G-Levine/OpenTorque-Actuator/README.md

# OpenTorque Actuator
### A powerful, compliant actuator for legged robotics.

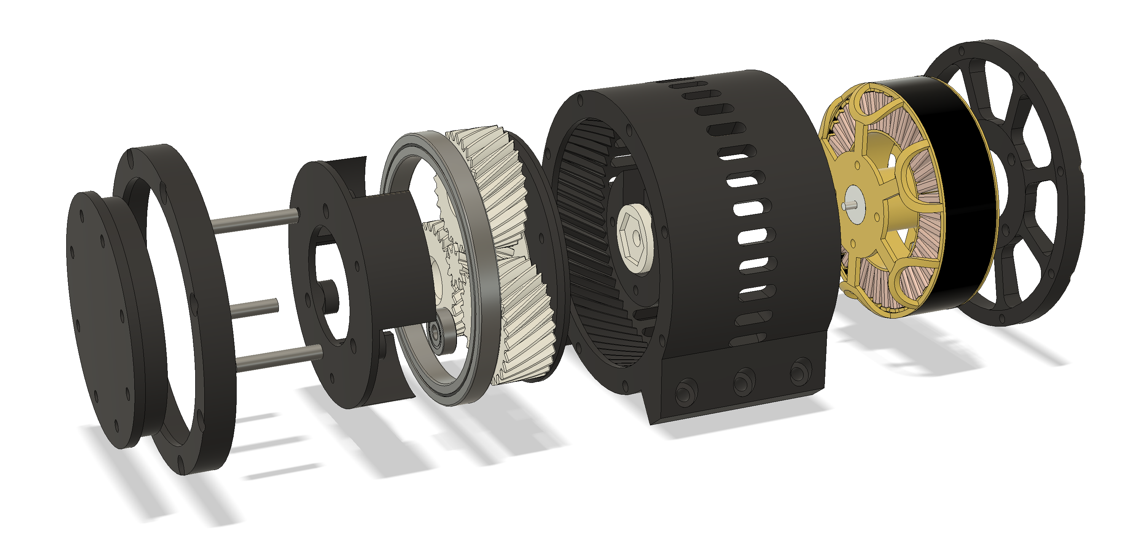
[picture p1: images/exploded_view.png]
Exploded view
