G-Levine/OpenTorque-Actuator/STL/Sun Gear low backlash.stl

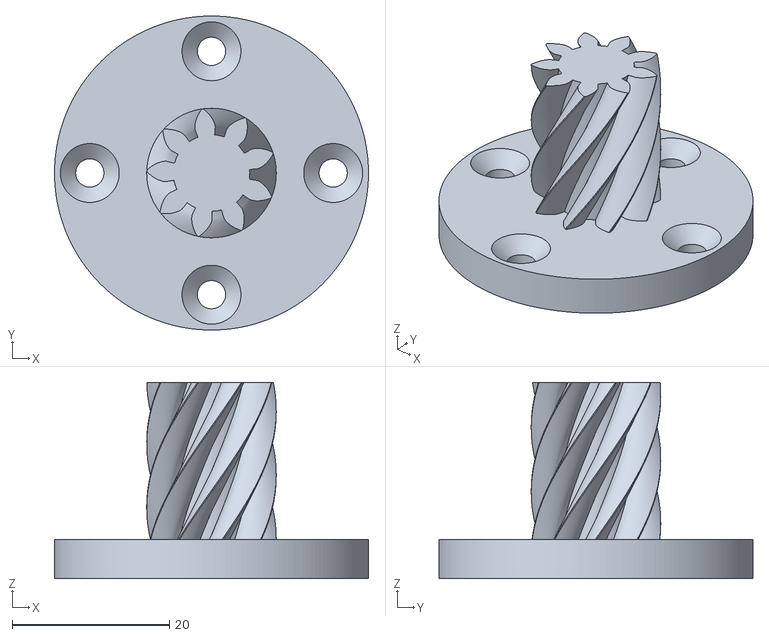
[picture p2: CAD file, 2019-04-21]
STL/Sun Gear low backlash.stl
40.0 x 40.0 x 25.0
