G-Levine/OpenTorque-Actuator/STL/Planet Gear low backlash.stl

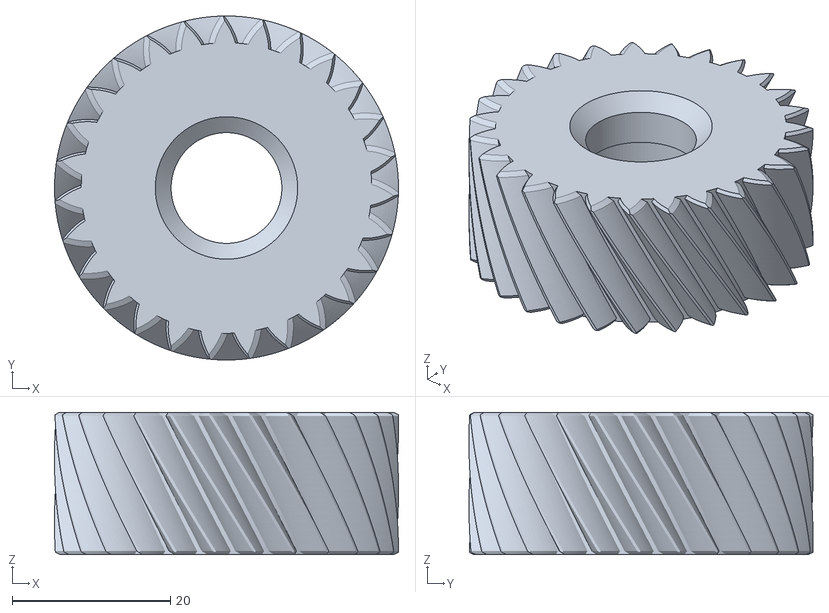
[picture p3: CAD file, 2019-04-21]
STL/Planet Gear low backlash.stl
43.5 x 43.5 x 18.0
