G-Levine/OpenTorque-Actuator/STL/Encoder Magnet Holder.stl

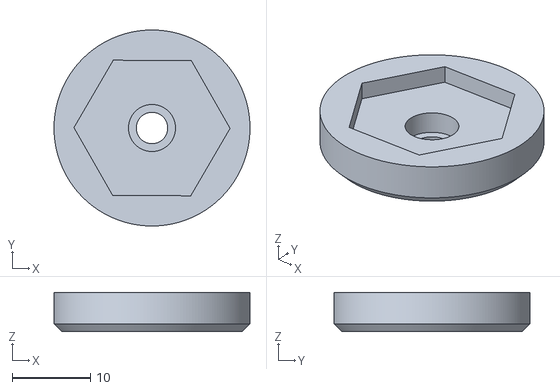
[picture p4: CAD file, 2019-02-14]
STL/Encoder Magnet Holder.stl
25.0 x 25.0 x 5.00
