G-Levine/OpenTorque-Actuator/STL/Planet Carrier A.stl

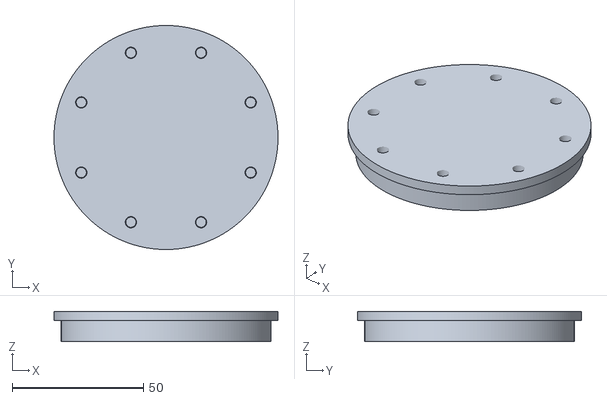
[picture p5: CAD file, 2019-02-14]
STL/Planet Carrier A.stl
85.5 x 85.5 x 11.5
