G-Levine/OpenTorque-Actuator/STL/Encoder Cover.stl

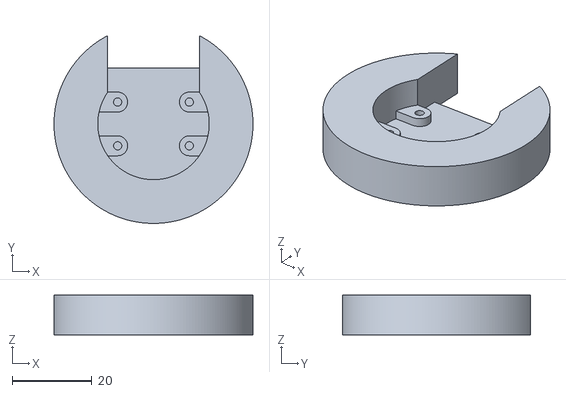
[picture p6: CAD file, 2019-02-14]
STL/Encoder Cover.stl
50.0 x 47.2 x 10.0
