G-Levine/OpenTorque-Actuator/STL/Backplate.stl

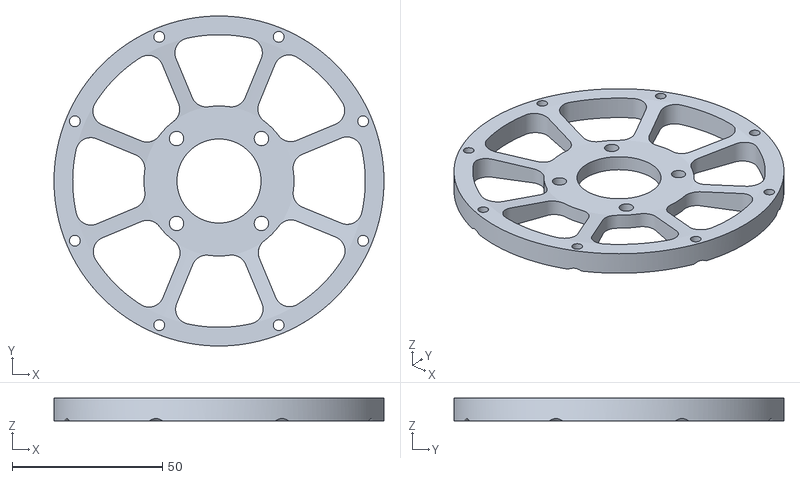
[picture p7: CAD file, 2019-02-14]
STL/Backplate.stl
110.0 x 110.0 x 7.50
