G-Levine/OpenTorque-Actuator/STL/Actuator Housing.stl

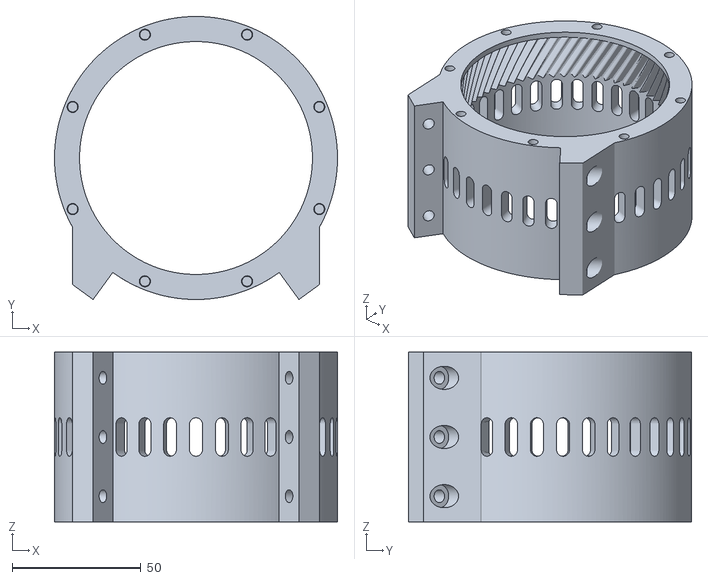
[picture p8: CAD file, 2019-02-14]
STL/Actuator Housing.stl
110.0 x 110.0 x 66.0
