G-Levine/OpenTorque-Actuator/STL/Planet Carrier B.stl

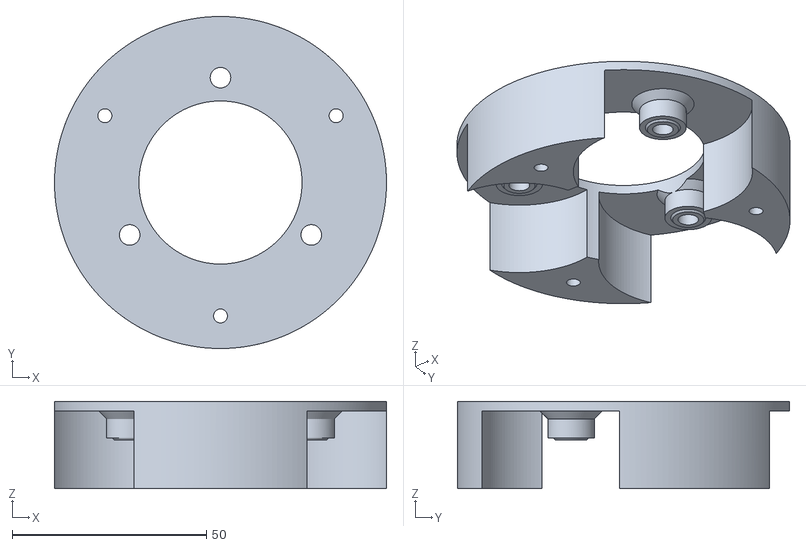
[picture p9: CAD file, 2019-02-14]
STL/Planet Carrier B.stl
85.5 x 85.5 x 22.5
