G-Levine/OpenTorque-Actuator/STL/Sun Gear.stl

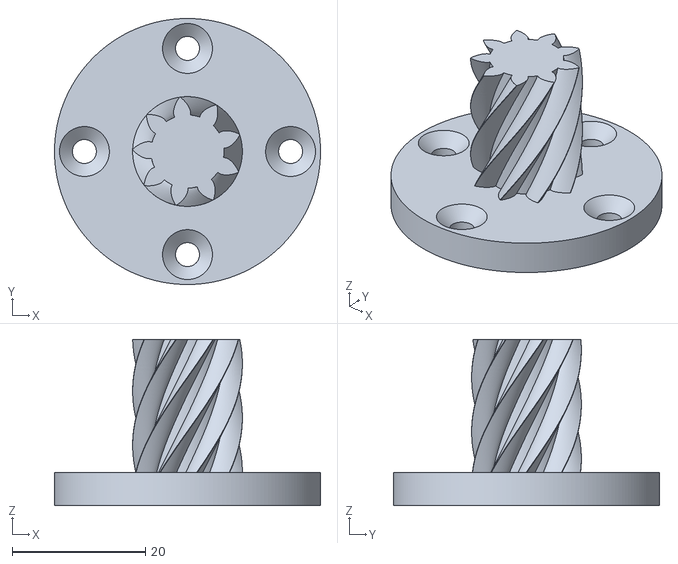
[picture p10: CAD file, 2019-02-14]
STL/Sun Gear.stl
40.0 x 40.0 x 25.0
