G-Levine/OpenTorque-Actuator/STL/Bearing Retainer.stl

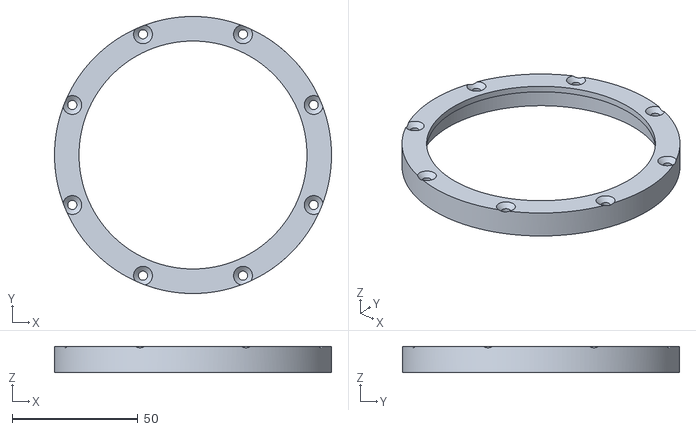
[picture p11: CAD file, 2019-02-14]
STL/Bearing Retainer.stl
110.0 x 110.0 x 10.5
