G-Levine/OpenTorque-Actuator/STL/Planet Carrier C.stl

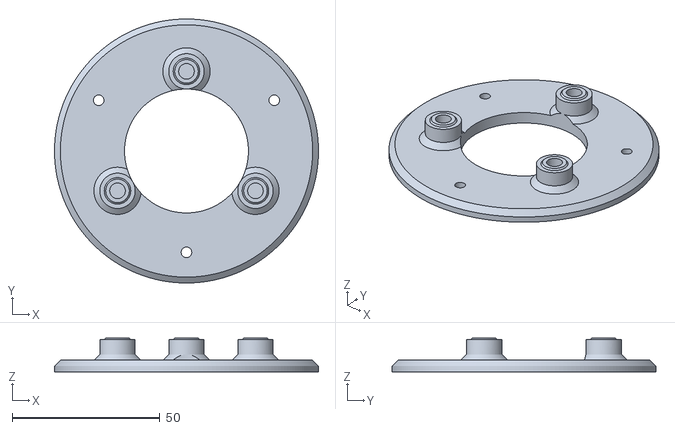
[picture p12: CAD file, 2019-02-14]
STL/Planet Carrier C.stl
89.5 x 89.5 x 11.5
