G-Levine/OpenTorque-Actuator/STL/Planet Gear.stl

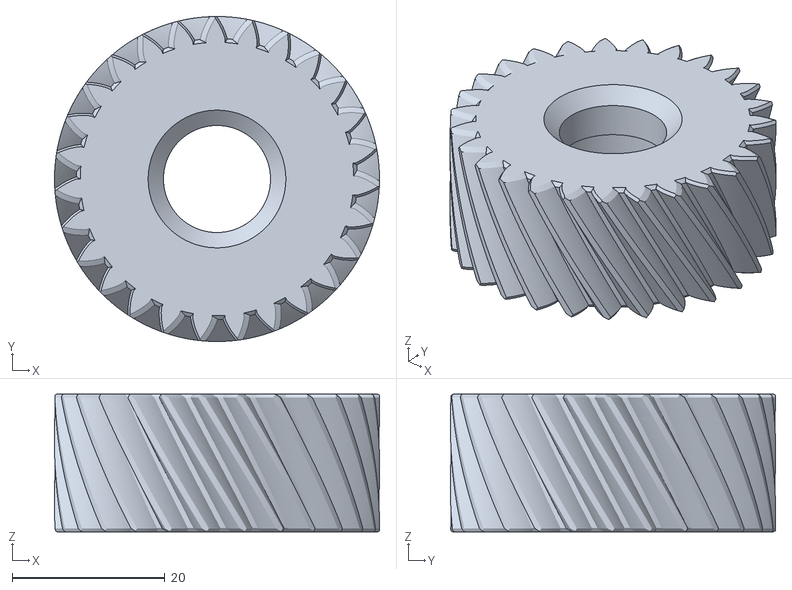
[picture p13: CAD file, 2019-02-14]
STL/Planet Gear.stl
42.5 x 42.5 x 18.0
