G-Levine/OpenTorque-Actuator/(threads)

Thread 1 (2019-04-29):

Bearings

Cullen-Dubbs, 2019-04-29:
Hi there,

I am a little confused about the bearings. I have the 16mm OD bearings you have on the parts list. I somewhat see what the design calls for with the slot in the center for the bearing to go into. But I am not able to fit the bearing in. Do I need to place the bearing in there mid print?

G-Levine, 2019-04-29:
Yes that’s correct, the bearing goes in mid-print. Sorry, the instructions aren’t clear. I will update them to explain it better.

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

Cullen-Dubbs, 2019-04-29:
No problem! I'm having alot of fun putting this together!

createthis, 2019-11-30:
Is there a specific height at which the print should be paused? I’m printing on an Ultimaker 2+ and I’m trying to figure out how to make this happen most efficiently.

Thread 2 (2019-05-22):

Off-Center Occilation

Cullen-Dubbs, 2019-05-22:
we seem to have an issue when the motor rotates slightly off center? We have been troubleshooting for a while now and cant seem to pinpoint any failures.

Have you even run into this?

Thanks!

-Cullen

G-Levine, 2019-05-28:
I haven’t run into that. Make sure your printer bed is leveled. The motor mount not being printed flat could cause that.

Thread 3 (2019-09-16):

X8318S/9235 motor model

solomondg, 2019-09-16:
Hey there! Maybe I'm just totally incompetent, but I haven't been able to find a model out there for 9235 class brushless motors. Seems there's one present in a lot of the renders - if you're at liberty to share it, would you mind popping it into the repo and saving us the trouble of modeling it ourselves?

Thanks a ton!

G-Levine, 2019-09-17:
Hi,
I didn't make the model for the 9235 motor shown in the pictures; it's borrowed from Robin Frojd's RFX gearbox (https://hackaday.io/project/162387-rfx-gearbox). You can download his STEP file to get the motor model.

solomondg, 2019-09-18:
Oh wow, thank you so much! Appreciate the link :)

Closed 2019-09-17.

Thread 4 (2019-12-14):

Cheaper Bearing?

IpsumDominum, 2019-12-14:
Hey :)
I am a very beginner,
It seems like the https://www.alibaba.com/product-detail/RA8008-crossed-roller-bearing-THK-bearing_1912942608.html bearing from alibaba is quite high priced.. What would be an alternative?

Thanks!
C Lu

rohanbaba, 2020-02-08:
Try searching for 61816-ZZ and you will find it in your local stores online. (eg. https://www.bearingrevolution.co.uk/61816-zz-60330)
This is a relatively very common type of bearing as well as very cheap with similar dimensions.
To use this bearing in the assembly, you will need to slightly tweak some dimensions of its housing.

STGRobotics, 2021-03-05:
https://www.amazon.com/Ochoos-80x100x10mm-Precision-Groove-Bearings/dp/B07R5Q6BBB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

https://www.astbearings.com/catalog/thin_section_metric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

IpsumDominum, 2021-03-16:
Thanks very much!

Closed 2021-03-16.

Thread 6 (2021-03-05):

A bit new to things

lonnietc, 2021-03-05:
Hi All,

I am researching to possibly initially build something similar to the MIT Cheetah and was looking for alternatives to their motor which is expensive. Especially in that you need 12 of them. I reasoned that perhaps one could use a standard BLDC motor and Planetary Gearbox assembly for 8 DOF and the MIT Motor for 4 DOF and still retain the power to do things like back-flips, etc.

In any case, I came across the OpenTorque project and motor development and wondered if it could be used instead?

If this were to go well then may it could be produced cheaper and also used in more advanced bipedal projects to come in the future if this works.

Any suggestions or insights would be very helpful.
Cheers
