G-Levine/OpenTorque-Actuator/(commit log)

2019-02-14 Add STLs, BoM, and print instructions
    [Actuator Housing.stl, Backplate.stl, Bearing Retainer.stl, Bill of Materials.csv, Encoder Cover.stl, Encoder Magnet Holder.stl, Planet Carrier A.stl, Planet Carrier B.stl]
2019-04-21 Add low-backlash versions of the sun and planet gears
    [Planet Gear low backlash.stl, Sun Gear low backlash.stl]
